camhodges101/ElectronicsDesign/Schematic-A2.pdf

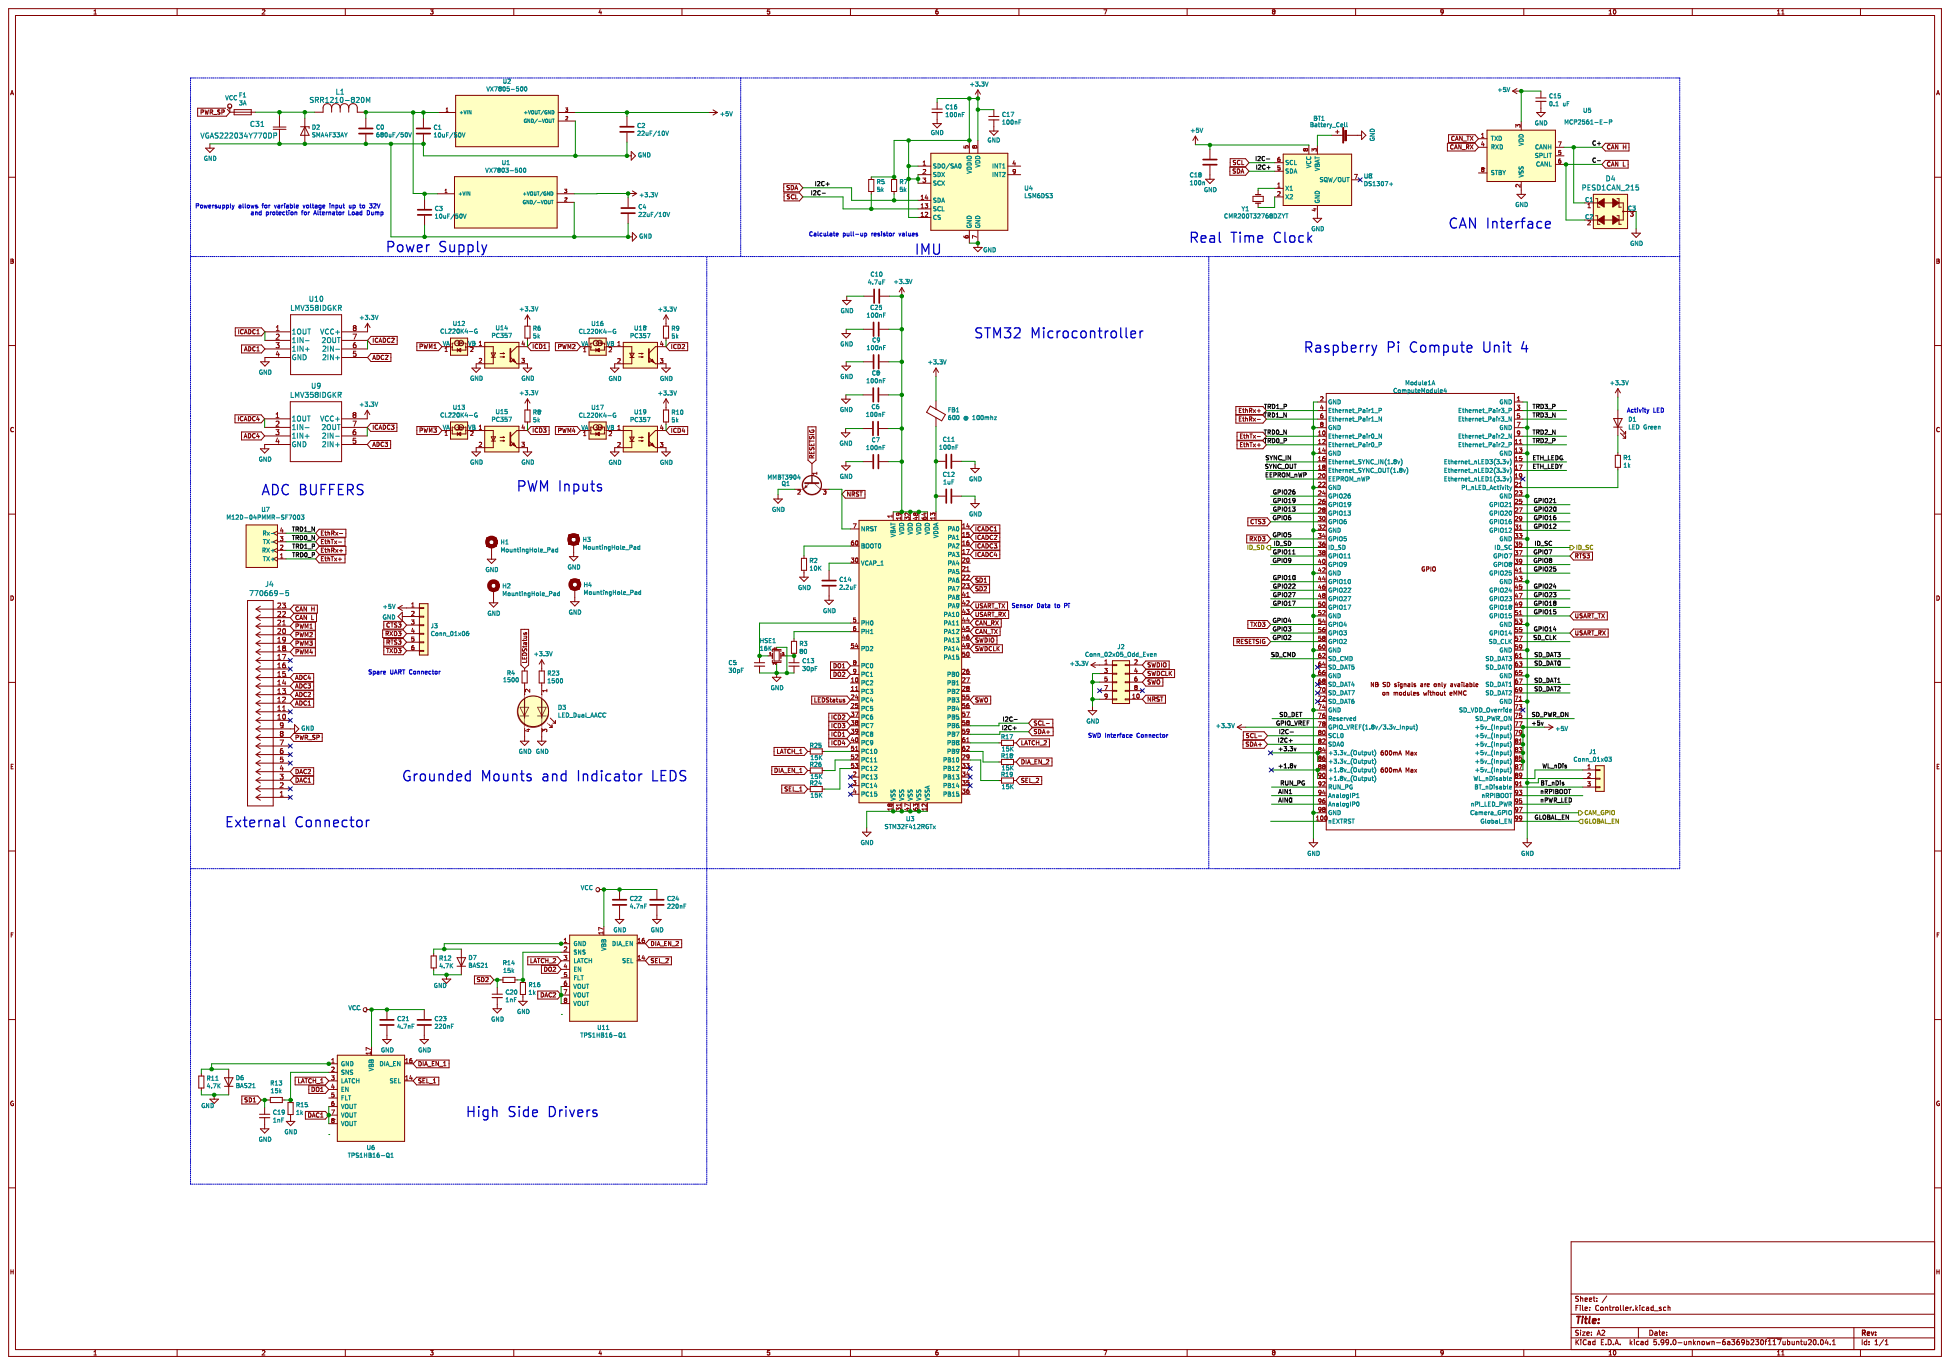
[picture p4: page 1]
