camhodges101/ElectronicsDesign/PCB.pdf

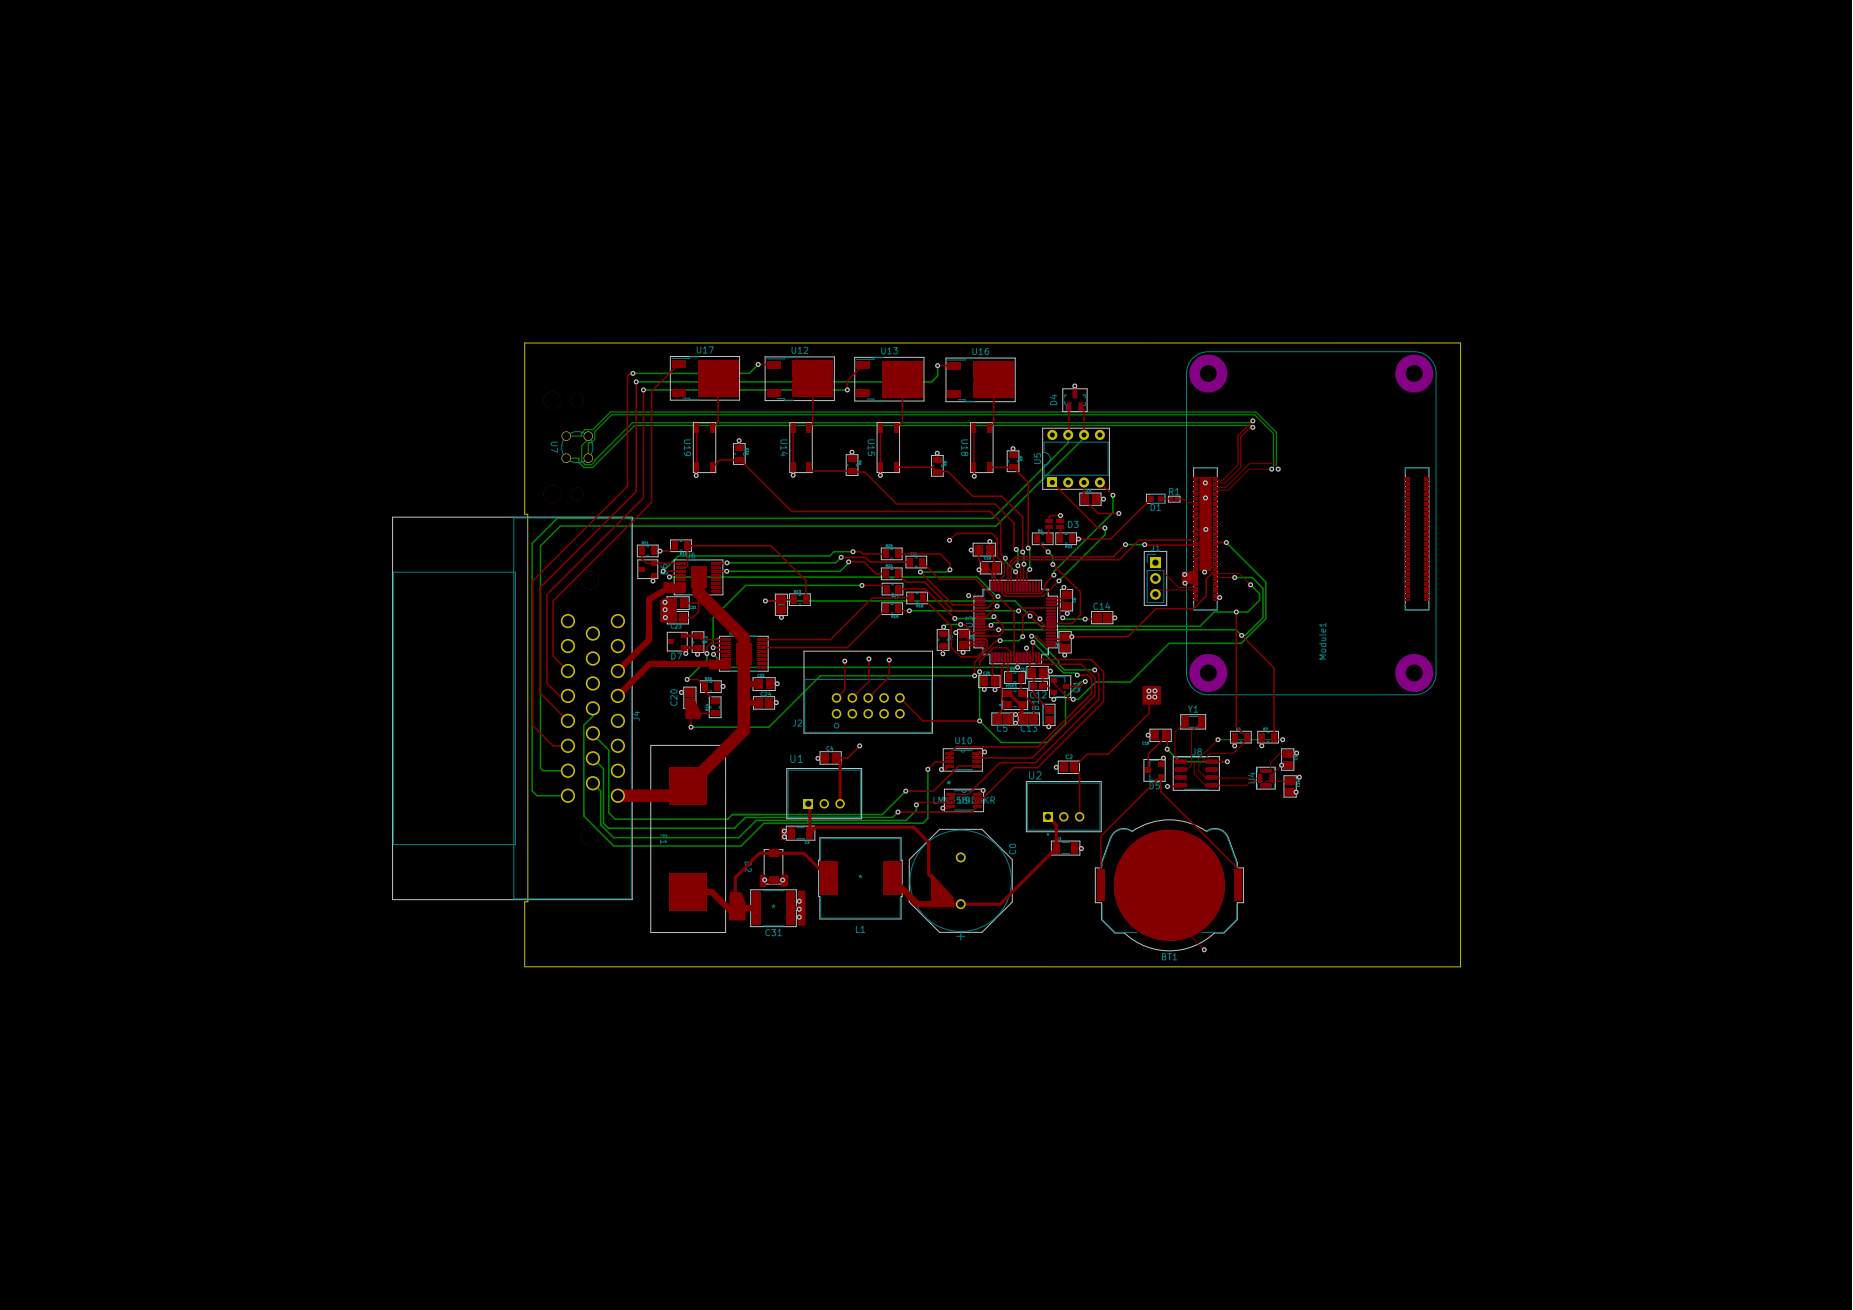
[picture p5: page 1]
